Kolikon/Bike_meter/PCB/miernik/miernik-F_Cu.pdf

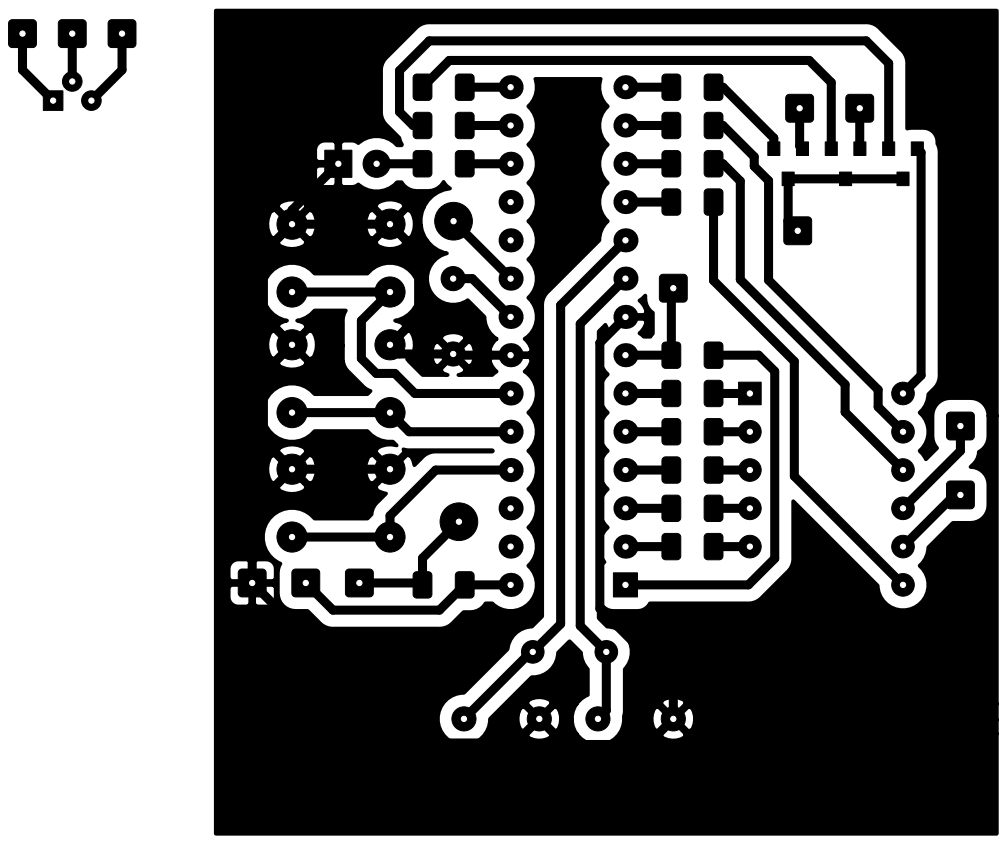
[picture p1: page 1]
