Kolikon/Bike_meter/PCB/miernik/miernik.kicad_pcb

## KiCad design PCB/miernik/miernik.kicad_pcb (2021-08-29)

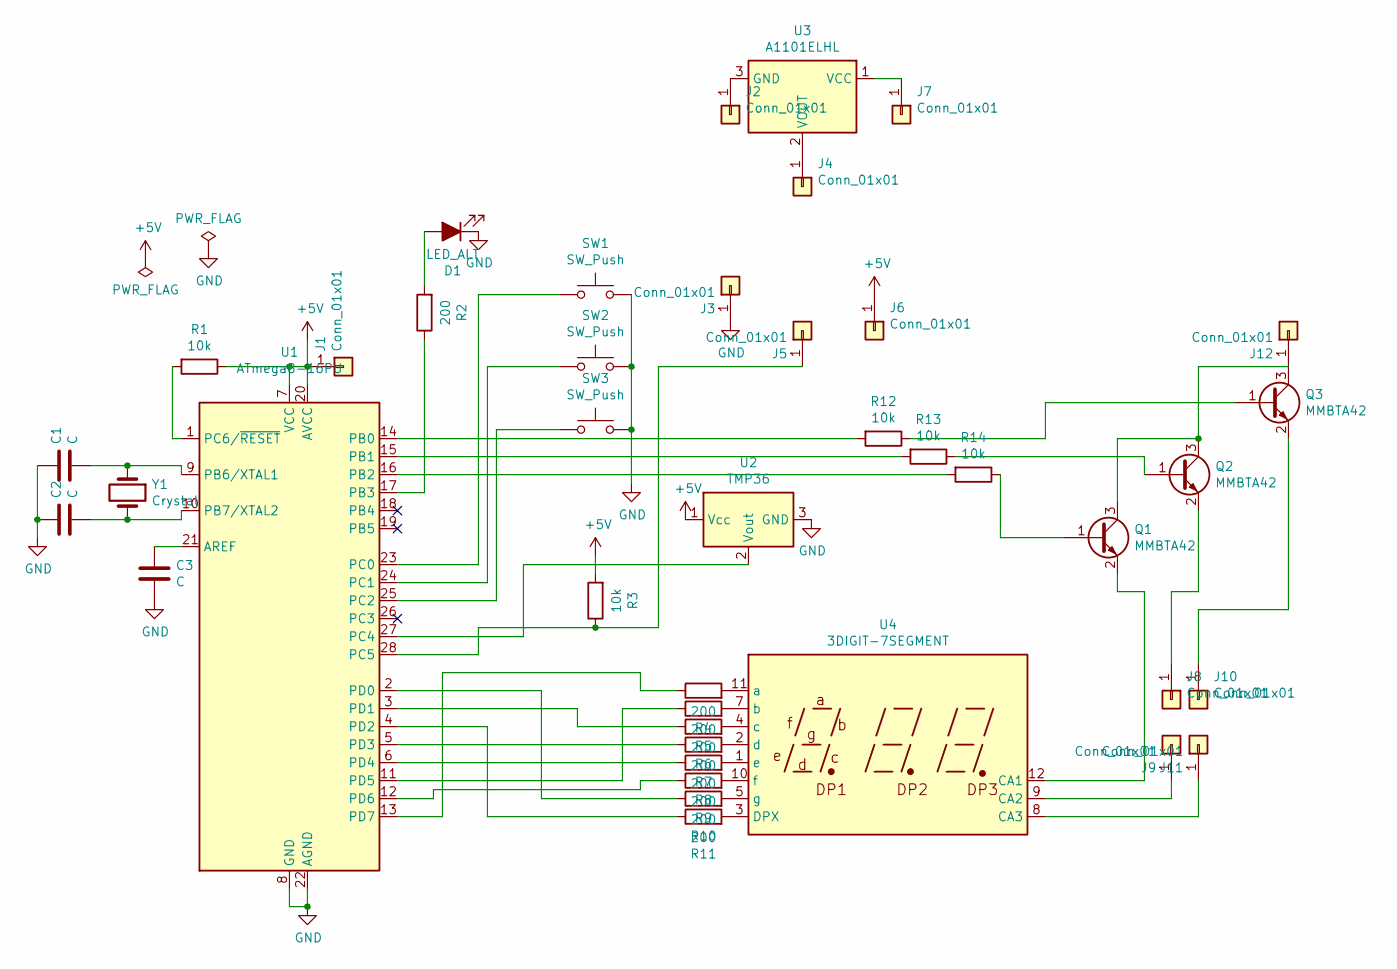
[picture p2: schematic miernik.sch]

Parts:
C1, C2: C; C_Disc_D5.0mm_W2.5mm_P5.00mm
C3: C; C_Disc_D7.0mm_W2.5mm_P5.00mm
D1: LED_ALT; LED_D3.0mm
J1, J2, J3, J4, J5, J6, J7, J8, J9, J10, J11, J12: Conn_01x01; SolderWire-0.25sqmm_1x01_D0.65mm_OD1.7mm
Q1, Q2, Q3: MMBTA42; SOT-23
R1, R3, R12, R13, R14: 10k; R_1206_3216Metric
R2, R4, R5, R6, R7, R8, R9, R10, R11: 200; R_1206_3216Metric
SW1, SW2, SW3: SW_Push; SW_PUSH_6mm
U1: ATmega8-16PU; DIP-28_W7.62mm_Socket
U2: TMP36; TO-92
U3: A1101ELHL; TO-92
U4: 3DIGIT-7SEGMENT
Y1: Crystal; Crystal_HC49-4H_Vertical

Connections:
+5V: J1.1, J6.1, R1.1, R3.2, U1.7 (VCC), U1.20 (AVCC), U2.1 (Vcc)
GND: C1.1, C2.1, C3.2, D1.1 (K), J3.1, SW1.2, SW2.2, SW3.2, U1.8 (GND), U1.22 (AGND), U2.3 (GND)
unnamed: C1.2, U1.9 (PB6/XTAL1), Y1.1
unnamed: C2.2, U1.10 (PB7/XTAL2), Y1.2
unnamed: C3.1, U1.21 (AREF)
unnamed: D1.2 (A), R2.2
unnamed: J2.1, U3.3 (GND)
unnamed: J4.1, U3.2 (VOUT)
unnamed: J5.1, R3.1, U1.28 (PC5)
unnamed: J7.1, U3.1 (VCC)
unnamed: J8.1, Q2.2 (E)
unnamed: J9.1, U4.9 (CA2)
unnamed: J10.1, Q3.2 (E)
unnamed: J11.1, U4.8 (CA3)
unnamed: J12.1, Q1.3 (C), Q2.3 (C), Q3.3 (C)
unnamed: Q1.1 (B), R14.1
unnamed: Q1.2 (E), U4.12 (CA1)
unnamed: Q2.1 (B), R13.1
unnamed: Q3.1 (B), R12.1
unnamed: R1.2, U1.1 (PC6/~RESET)
unnamed: R2.1, U1.17 (PB3)
unnamed: R4.1, U1.13 (PD7)
unnamed: R4.2, U4.11 (a)
unnamed: R5.1, U1.11 (PD5)
unnamed: R5.2, U4.7 (b)
unnamed: R6.1, U1.3 (PD1)
unnamed: R6.2, U4.4 (c)
unnamed: R7.1, U1.5 (PD3)
unnamed: R7.2, U4.2 (d)
unnamed: R8.1, U1.6 (PD4)
unnamed: R8.2, U4.1 (e)
unnamed: R9.1, U1.12 (PD6)
unnamed: R9.2, U4.10 (f)
unnamed: R10.1, U1.2 (PD0)
unnamed: R10.2, U4.5 (g)
unnamed: R11.1, U1.4 (PD2)
unnamed: R11.2, U4.3 (DPX)
unnamed: R12.2, U1.14 (PB0)
unnamed: R13.2, U1.15 (PB1)
unnamed: R14.2, U1.16 (PB2)
unnamed: SW1.1, U1.23 (PC0)
unnamed: SW2.1, U1.24 (PC1)
unnamed: SW3.1, U1.25 (PC2)
unnamed: U1.27 (PC4), U2.2 (Vout)

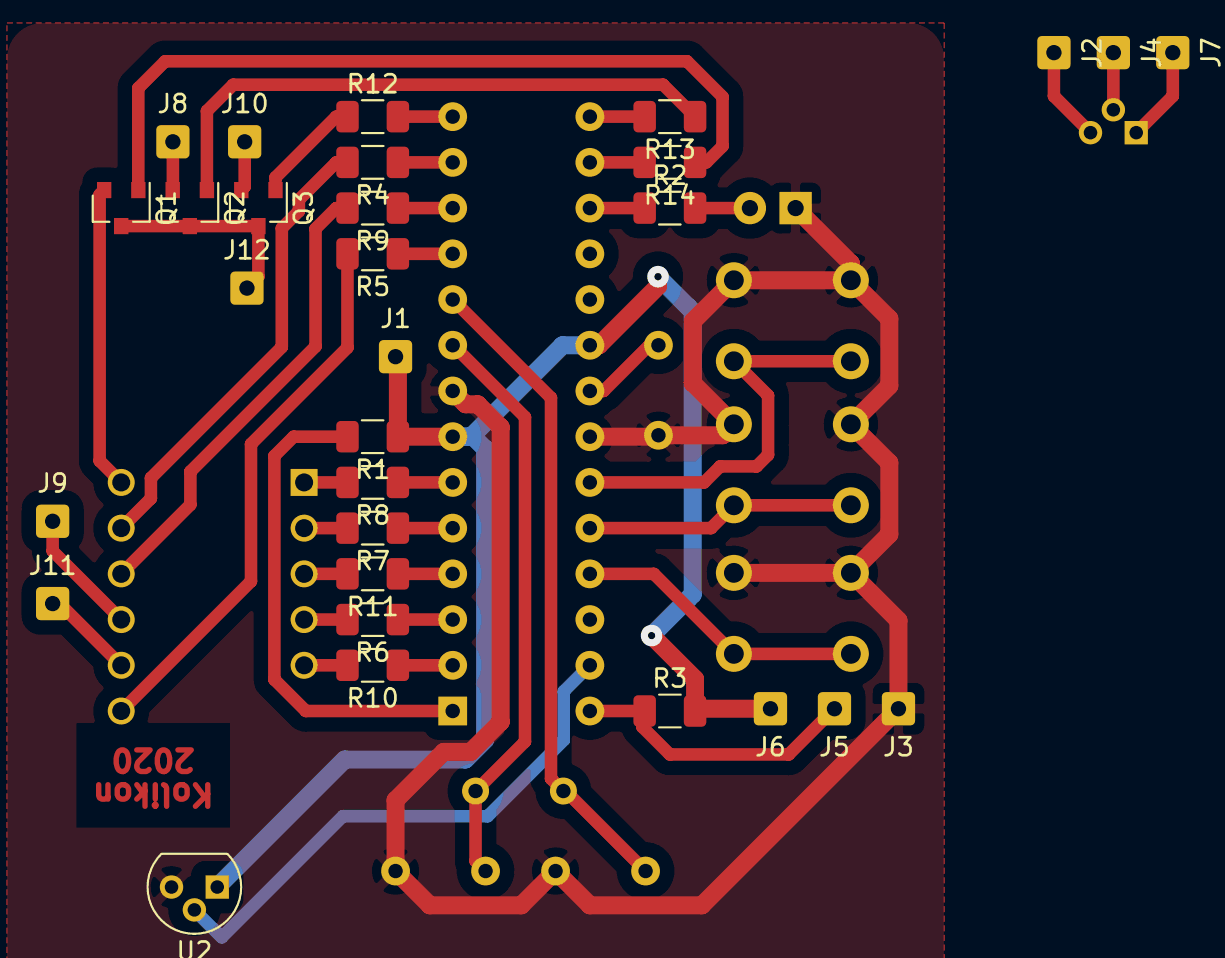
[picture p3: board miernik.kicad_pcb from above]

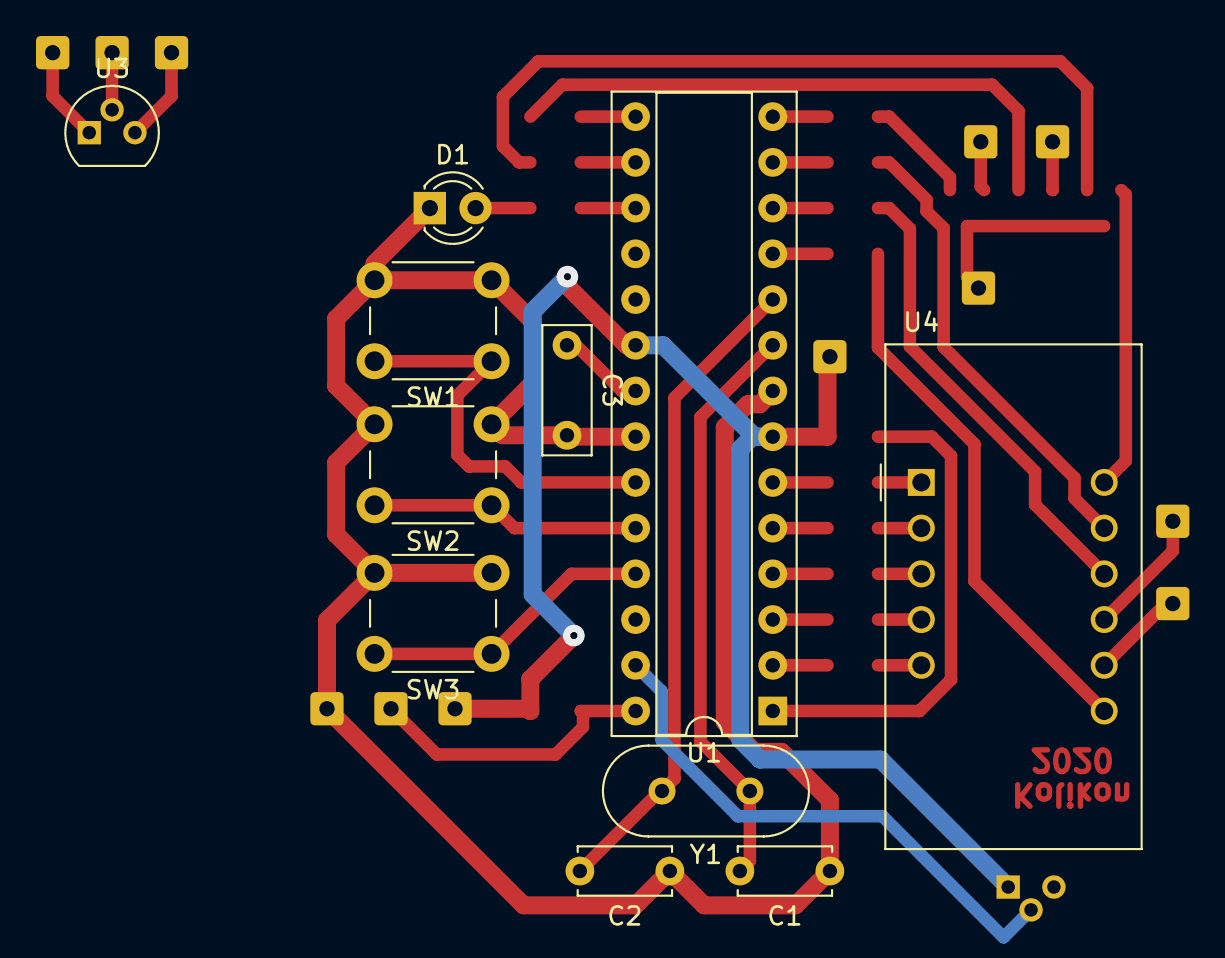
[picture p4: board miernik.kicad_pcb from below]

Board: 2 copper layers, 41 parts (11 on the bottom side), 44 nets.
